cloudbianca/wien-bridge-oscillator/Simulations/temp fmin zoom.jpg

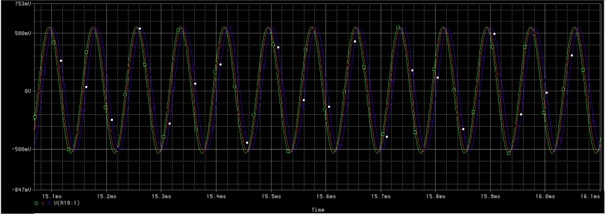
Simulations/temp fmin zoom.jpg
