cloudbianca/wien-bridge-oscillator/Simulations/temp zoom.jpg

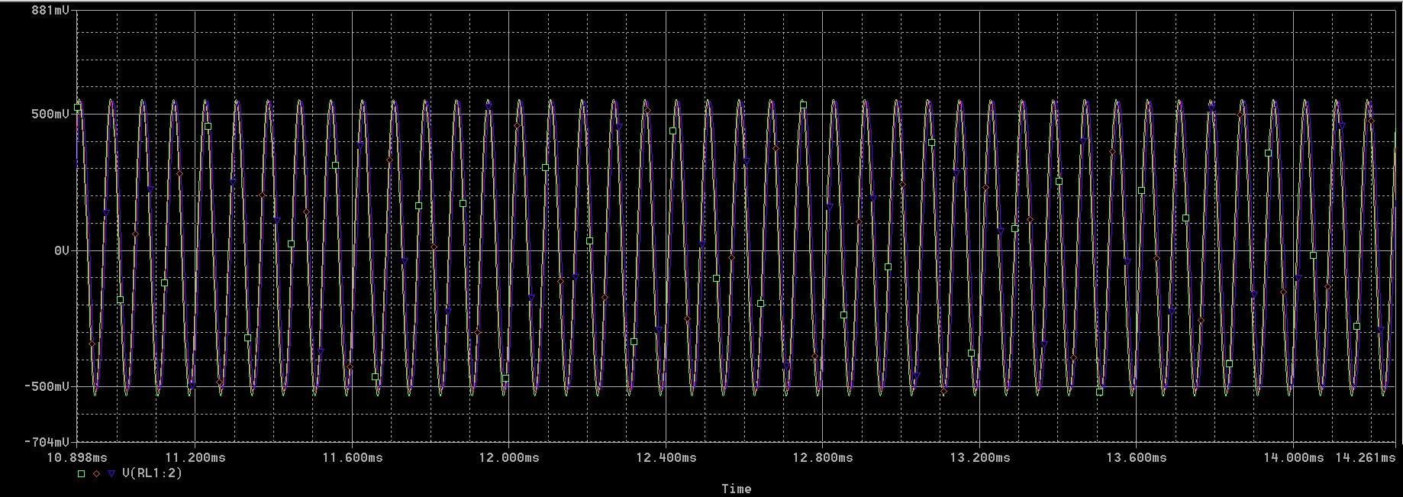
Simulations/temp zoom.jpg
