cloudbianca/wien-bridge-oscillator/Proiect docs/Documentatie part2.pdf

# UniversitateaNaționalădeÇtiință și Tehnologie Politehnica București

Facultatea de Electronică, Telecomunicații și Tehnologia Informației

# Oscilator RC cu punte Wien

## Circuiteelectronicefundamentale2

## Proiect

## Student:Rotariu Marina-Bianca

## Grupa: 433E

## Anul: 2025-2026

## Cuprins

1. Date de proiectare

N = 25

- Frecvența de oscilație reglabilă în intervalul {0.5*25 ; 3*25} [KHz] -> {12.5;75} [KHz]
- Sarcina de la ieșire 25 [KΩ];]
- Control automat al ampltudinii de oscilație realizat cu TEC-J
- Amplitudinea oscilației la ieșire 20/1.5*25 = 0.53 [V]
- Domeniul temperaturilor de funcționare: 0

0C - 70⁰C (verificabil prin testare în temperatură);
- Semnalizarea prezenței tensiunilor de alimentare cu diodă de tip LED
2. Schema bloc a circuitului

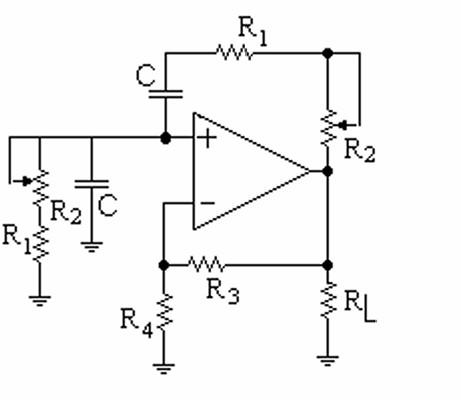
[picture p3: figure]

Putem identifica următoarele blocuri componente:

1. Amplificatorul de bază
2. Rețeaua de reacție pozitivă (rețeaua Wien) formată din R1, R2 și C
3. Rețeaua de reacție negativă formată din R3 și R4
4. Rezistența de sarcină RL

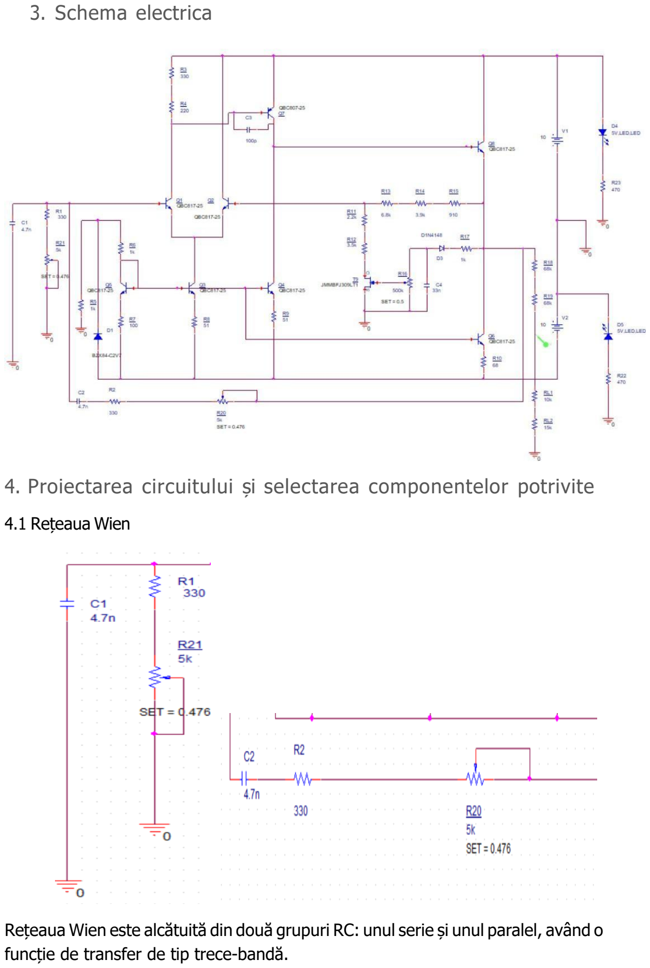
[picture p4: page 4]

3. Schema electrica
4. Proiectarea circuitului și selectarea componentelor potrivite

4.1 Rețeaua Wien

Rețeaua Wien este alcătuită din două grupuri RC: unul serie și unul paralel, având o funcție de transfer de tip trece-bandă.

Când rețeaua este atacată pe grupul serie și răspunde pe grupul paralel aceasta este cu transfer de tensiune. Când intrarea este pe grupul paralel și răspunde pe grupul serie, rețeaua este cu transfer de curent.

Este folosita datorită simplității implementării și posibilității de reglare a frecvenței de oscilație prin utilizarea unui potențiometru dublu în locul celor două rezistoare separate.

Factorul de transfer al rețelei este β =

1
, iar conform condiției de amorsare a oscilațiilor
3
Aβ = 1 => amplificarea totală a circuitului trebuie să fie egală cu 3.

Frecvența de oscilație se determină cu formula:

1
f =
2πRC

În general, în etapa de proiectare se fixează valoarea condensatoarelor, iar rezistența R se alege astfel încât să se obțină frecvența dorită.
Pentru acest scop, se utilizează un potențiometru standard de 5 kΩ, iar condensatoarele se stabilesc la C₁ = C₂ = 4.7 nF, pentru a acoperi o gamă convenabilă de reglaj a frecvenței.

Aplicând formula pentru limitele inferioară și superioară ale domeniului de frecvență

(fmin și fmax):

R =

1
2πCf

Rezultă:

- pentru fmin = 12.5 kHz, Rmax = 2700 Ω (SET = 0.476)
- pentru fmax = 75 kHz, Rmin = 450 Ω (SET = 0.024)

Datorita faptului ca nu beneficiez de o rezistenta de valoarea Rmin = 450Ω, am ales sa folosesc un rezistor de 330 Ω si sa reglez potentiometrul la valoarea de 0.024 astfel acumuland restul de 120 Ω lipsa.

4.2 Rețeaua de reacție negativă formată din R3 și R4;

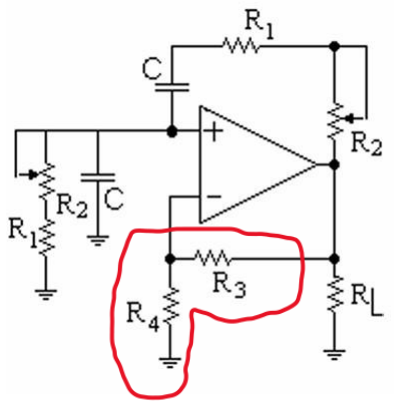
[picture p5: figure]

Bucla de reacție negativă are rolul de a stabiliza amplificarea în tensiune la o valoare constantă. Această amplificare este determinată exclusiv de valorile rezistențelor R3 si R4, conform relației:

A = 1 +

R3
R4

Pentru a îndeplini condiția lui Barkhausen, rezistența R3 trebuie să fie aproximativ de două ori mai mare decât R4, astfel încât amplificarea totală să fie cel puțin egală cu 3.

Dacă se alege R4 = 5.5 kΩ => R3trebuie să aibă o valoare teoretică de aproximativ 11.61 kΩ. În practică, această valoare se ajustează ușor peste cea teoretică pentru a garanta pornirea oscilațiilor si stabilizarea acestora.

4.3 Control automat al amplitudinii de oscilație realizat cu TEC-J

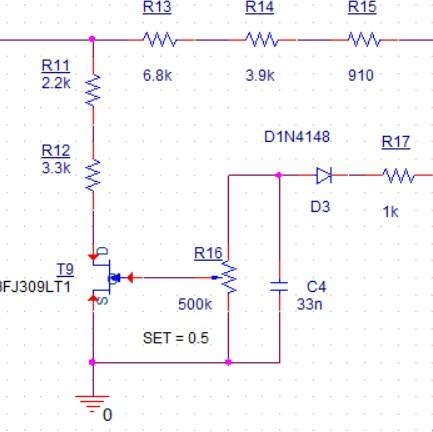
[picture p6: figure]

Detecția amplitudinii:

Dioda D3 împreună cu condensatorul C4 preiau semnalul de la ieșirea oscilatorului. Dioda realizează redresarea semnalului, iar condensatorul îl filtrează, obținându-se astfel o tensiune continuă proporțională cu amplitudinea oscilațiilor.

Controlul rezistenței:

Tensiunea continuă obținută este aplicată pe poarta tranzistorului JFET, care acționează ca o rezistență variabilă între drenă și sursă. Valoarea acestei rezistențe se modifică în funcție de tensiunea de pe poartă.

Reglarea câștigului:

Rezistența variabilă a tranzistorului JFET este inclusă în rețeaua de stabilire a câștigului amplificatorului din oscilator.

Atunci când amplitudinea oscilațiilor crește, tensiunea de control devine mai mare, determinând creșterea rezistenței. În consecință, câștigul amplificatorului scade, readucând amplitudinea la valoarea dorită.

În situația opusă, când amplitudinea scade, rezistența se diminuează, ceea ce mărește câștigul amplificatorului și restabilește amplitudinea corectă a oscilațiilor.

4.4 Amplificatorul de baza

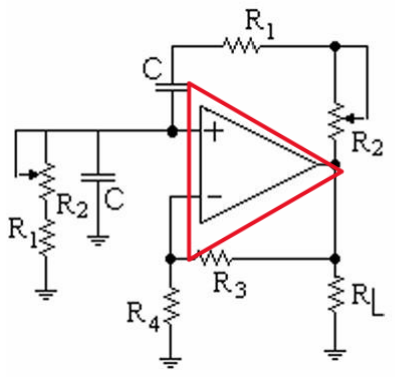
[picture p7: figure]

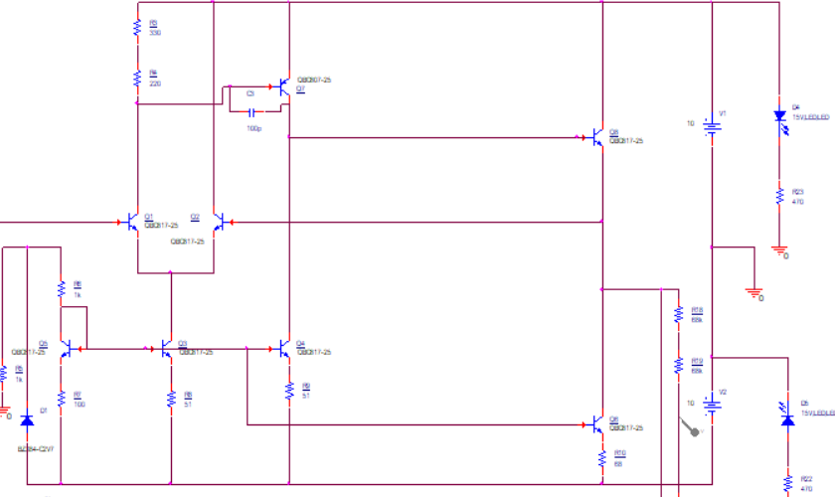
[picture p8: figure]

Acesta este un amplificator audio de putere în clasă AB, realizat într-o structură clasică pe trei etaje, optimizată pentru performanță ridicată.

1. Etajul de intrare

Tranzistoarele Q1 și Q2 alcătuiesc o pereche diferențială care primește semnalul de intrare. Împreună cu oglinda de curent formată din Q3 și Q5, acest etaj asigură un câștig inițial ridicat și o bună rejectare a zgomotului.

2. Etajul de amplificare în tensiune

Tranzistorul Q4, având ca sarcină activă pe Q7, realizează amplificarea principală în tensiune a semnalului, reprezentând secțiunea care furnizează cea mai mare parte a câștigului total.

3. Etajul de ieșire

Tranzistoarele Q7 și Q8 formează un etaj de tip „push-pull”, capabil să furnizeze curentul necesar sarcinii. Circuitul din jurul lui Q8 stabilește tensiunea de funcționare necesară celor două tranzistoare, astfel încât ele să preia semnalul în mod continuu, fără pauze între jumătățile de undă. În acest fel sunt eliminate distorsiunile de trecere prin zero caracteristice amplificatoarelor în clasă AB.

4.5 Etaje principale și funcții

Oglinda de curent și sursa de referință: Q3, Q5, D2

Dioda D2 creează tensiunea de referință necesară, iar tranzistoarele Q3 și Q5, configurate ca oglindă de curent, furnizează un curent constant care alimentează etajele sensibile. Astfel, circuitul este menținut stabil chiar dacă tensiunea de alimentare variază.

Sursă suplimentară de curent: Q4, Q6

Aceste tranzistoare extind rețeaua de alimentare cu curent constant și asigură polarizarea independentă a altor secțiuni, îmbunătățind separarea funcțională și stabilitatea ansamblului.

Etaj diferențial: Q1, Q2

Tranzistoarele Q1 și Q2 formează etajul diferențial care primește semnalul de intrare. Acesta oferă un bun raport de respingere a modului comun și stabilește baza pentru oscilații. Curentul stabil furnizat de oglinda de curent menține funcționarea corectă a etajului.

Etajul de amplificare în emitor comun: Q7

Tranzistorul Q7 amplifică semnalul provenit din etajul diferențial. Împreună cu rezistențele asociate, influențează factorul de calitate și lățimea de bandă a oscilatorului, contribuind la forma finală a semnalului generat.

Etajul de ieșire: Q8

Acest etaj asigură livrarea semnalului către sarcină, oferind curentul și tensiunea necesare pentru o ieșire stabilă și neafectată de variațiile în rețelele interne.

Rețeaua Wien: R1, R2, C1, C2, R20, R21

Rețeaua RC variabilă formată din aceste componente stabilește frecvența de oscilație. Reglajul potențiometrelor permite acoperirea intervalului 12.5–75 kHz, adaptând oscilatorul la cerințele utilizatorului.

Rețeaua de reacție negativă: R11, R12, R13, R14, R15

Aceste rezistențe fixează nivelul de feedback negativ, menținând câștigul aproape de valoarea critică necesară rețelei Wien (~2), astfel încât oscilațiile să fie susținute fără să crească sau să scadă necontrolat.

JFET-ul T9, dioda D3, rezistența R17 și condensatorul C4

- JFET-ul T9 acționează ca o rezistență variabilă în bucla de reacție, controlând automat câștigul.
- D3 redresează semnalul, permițând doar componenta pozitivă să încarce C4.

- C4 stochează tensiunea de vârf, creând o componentă DC lent variabilă, care reglează poarta JFET-ului.
- R17 limitează curentul și stabilește viteza de încărcare/descărcare a lui C4, reglând pragul la care amplitudinea este redusă.

Când amplitudinea crește, tensiunea rectificată devine mai mare → poarta JFET este polarizată invers → rezistența JFET crește → câștigul scade.
Când amplitudinea scade, procesul se inversează, păstrând semnalul stabil și nedistorsionat.

Capacitatea Miller: C3

Condensatorul C3 introduce feedback capacitiv, reducând banda de frecvențe și eliminând oscilațiile parazite. Ajută astfel la obținerea unei oscilații curate în intervalul dorit de 12.5 – 75 kHz.

5. Calculul analitic al circuitului

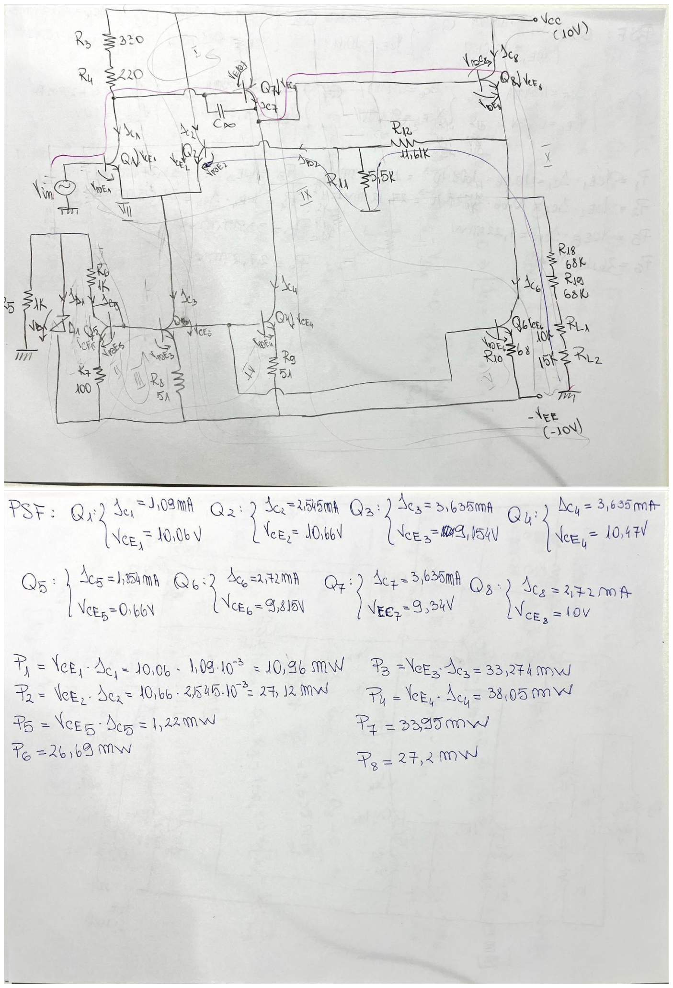
[picture p9: page 11]
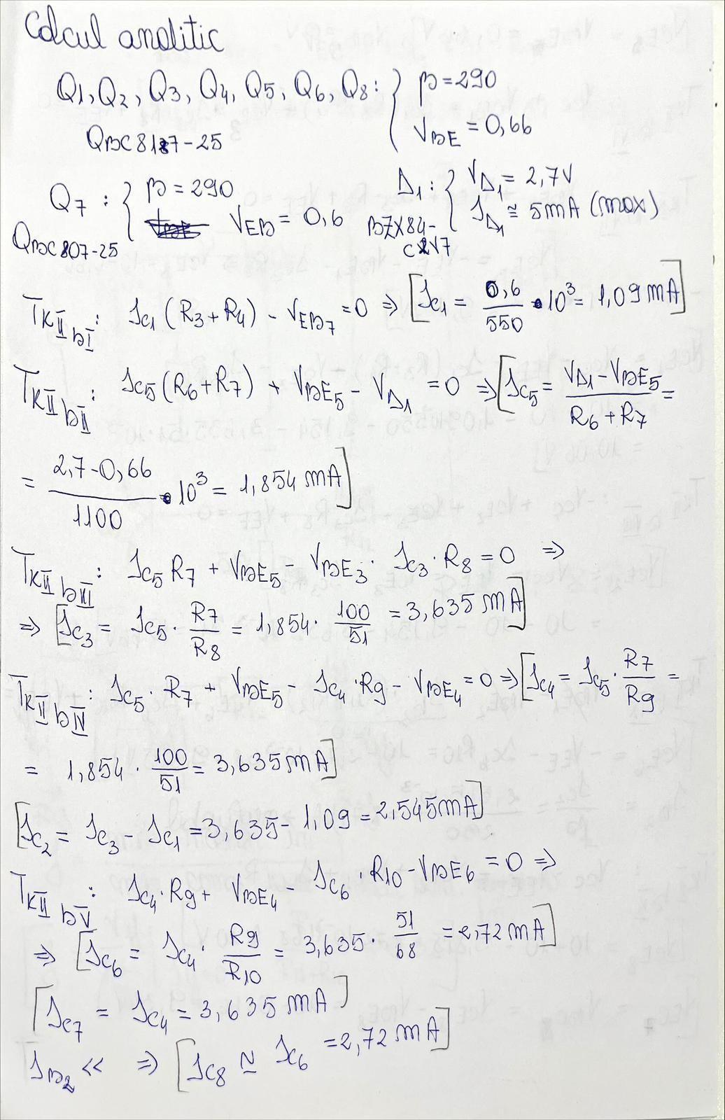
[picture p10: page 12]
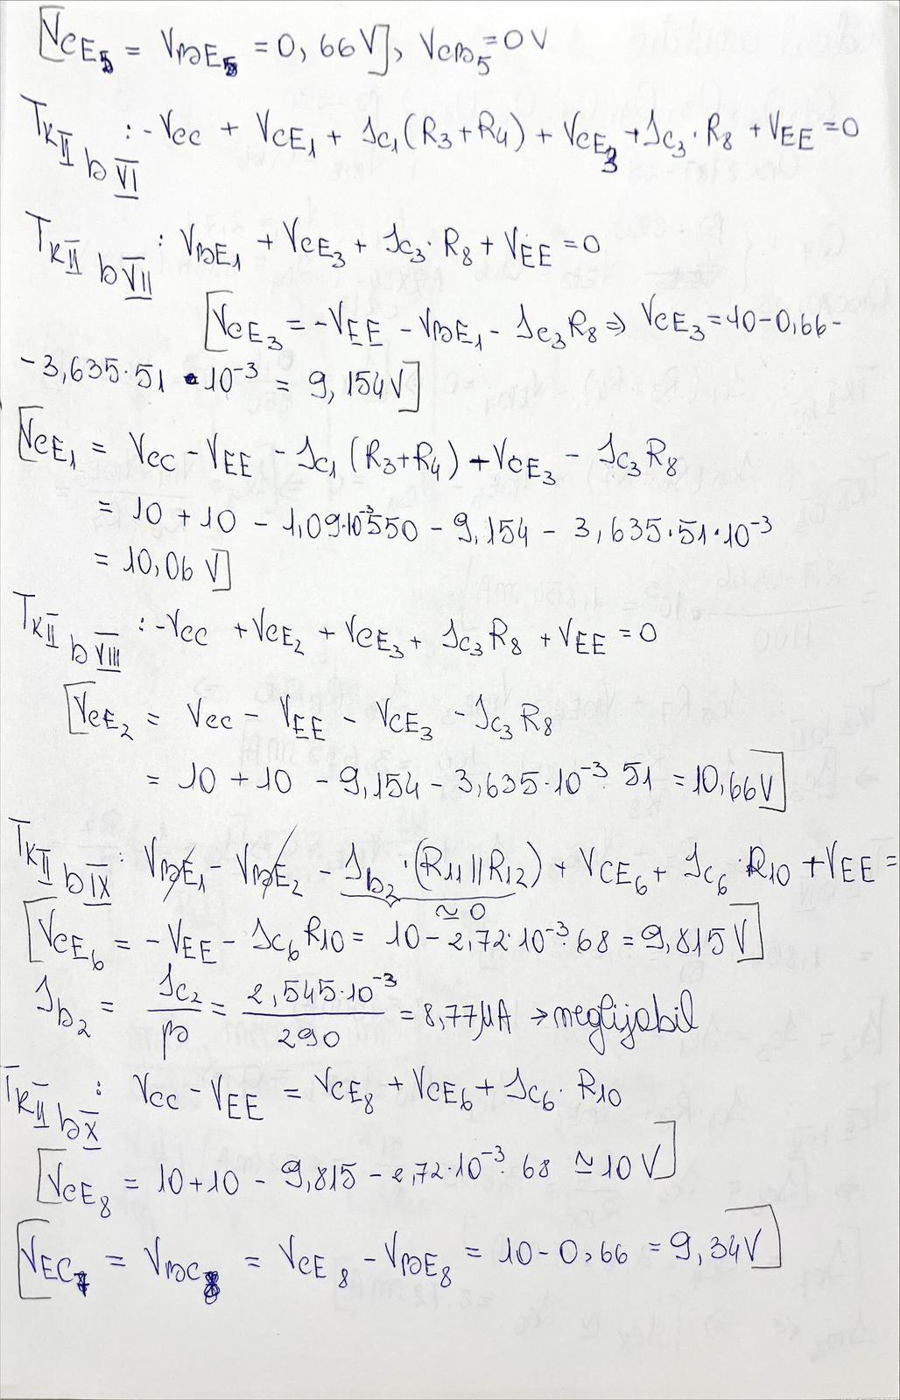
[picture p11: page 13]
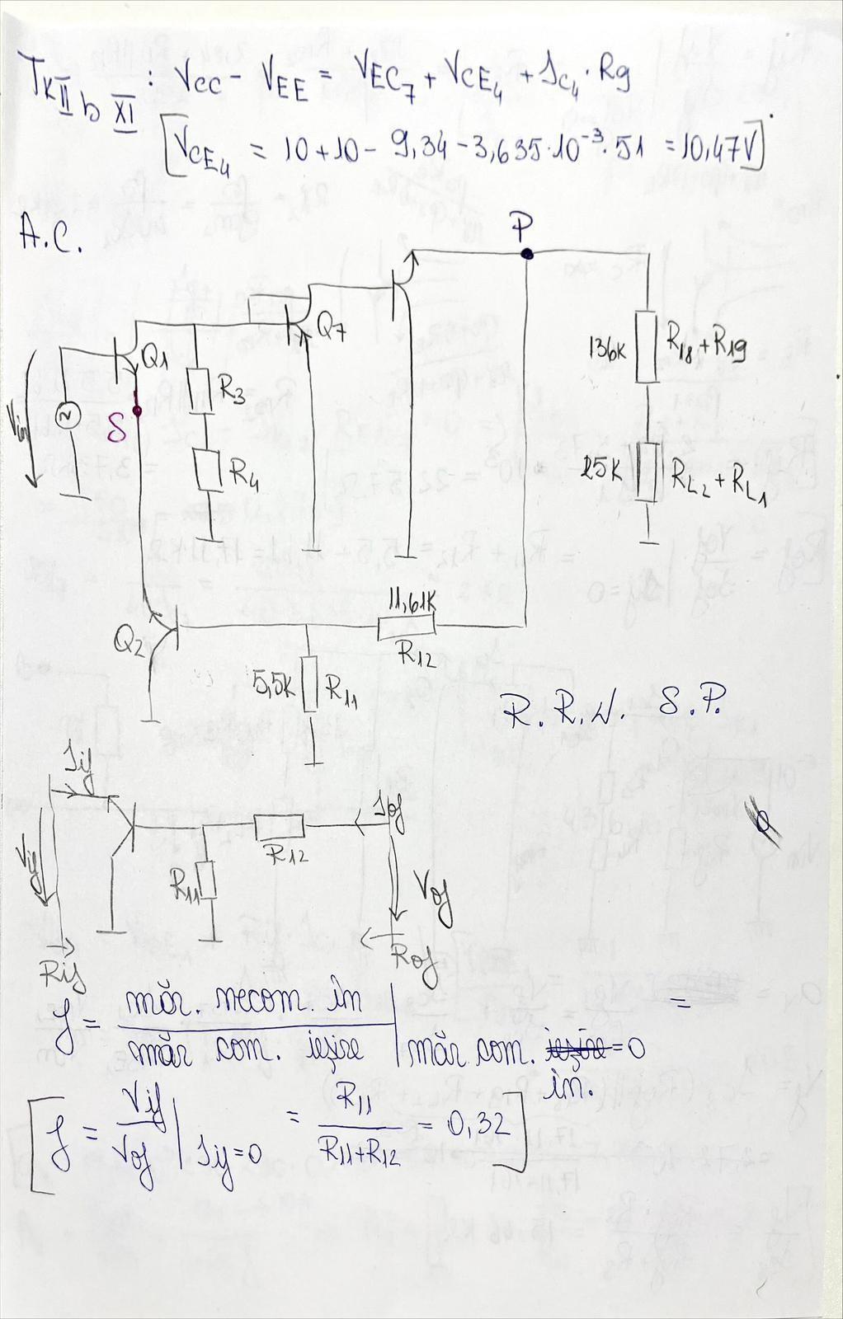
[picture p12: page 14]
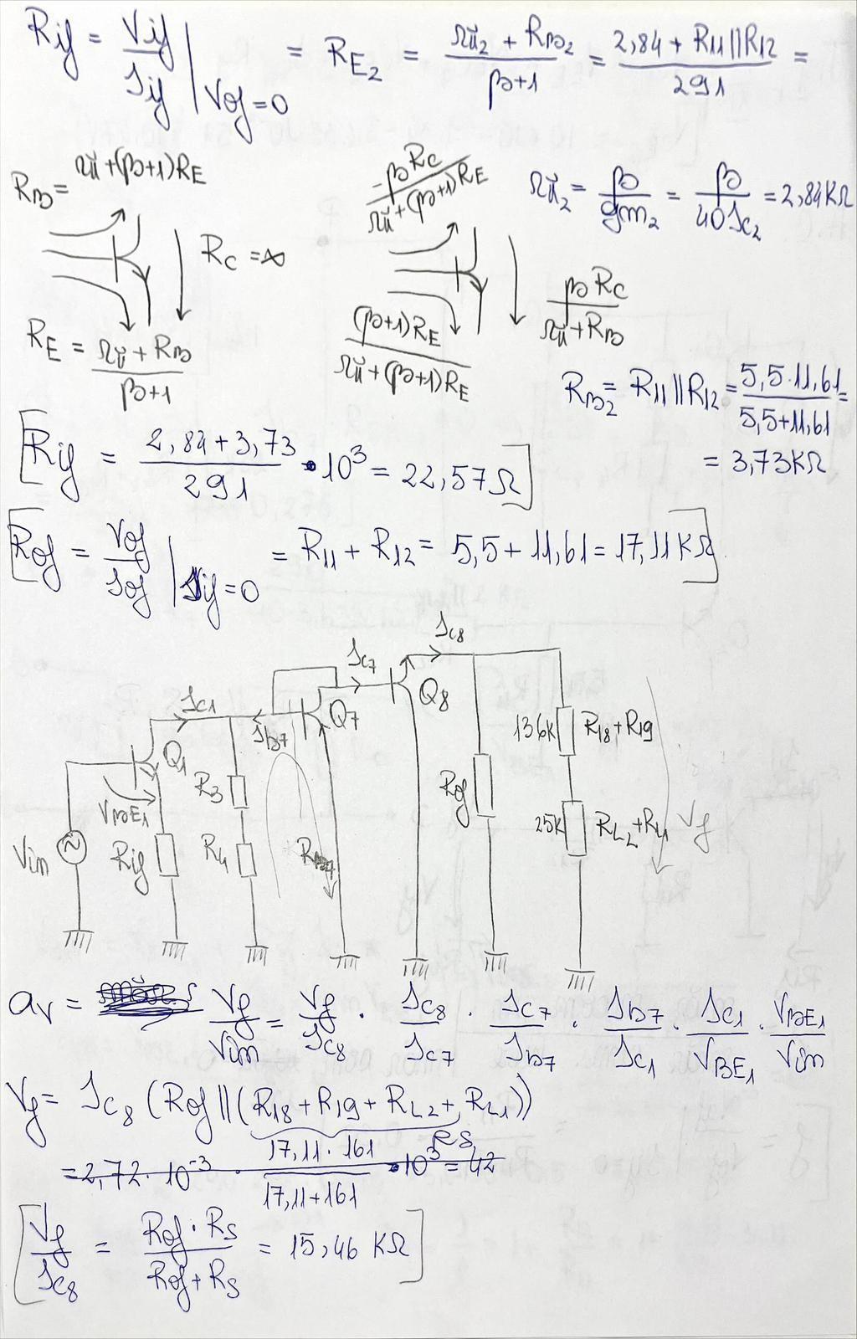
[picture p13: page 15]
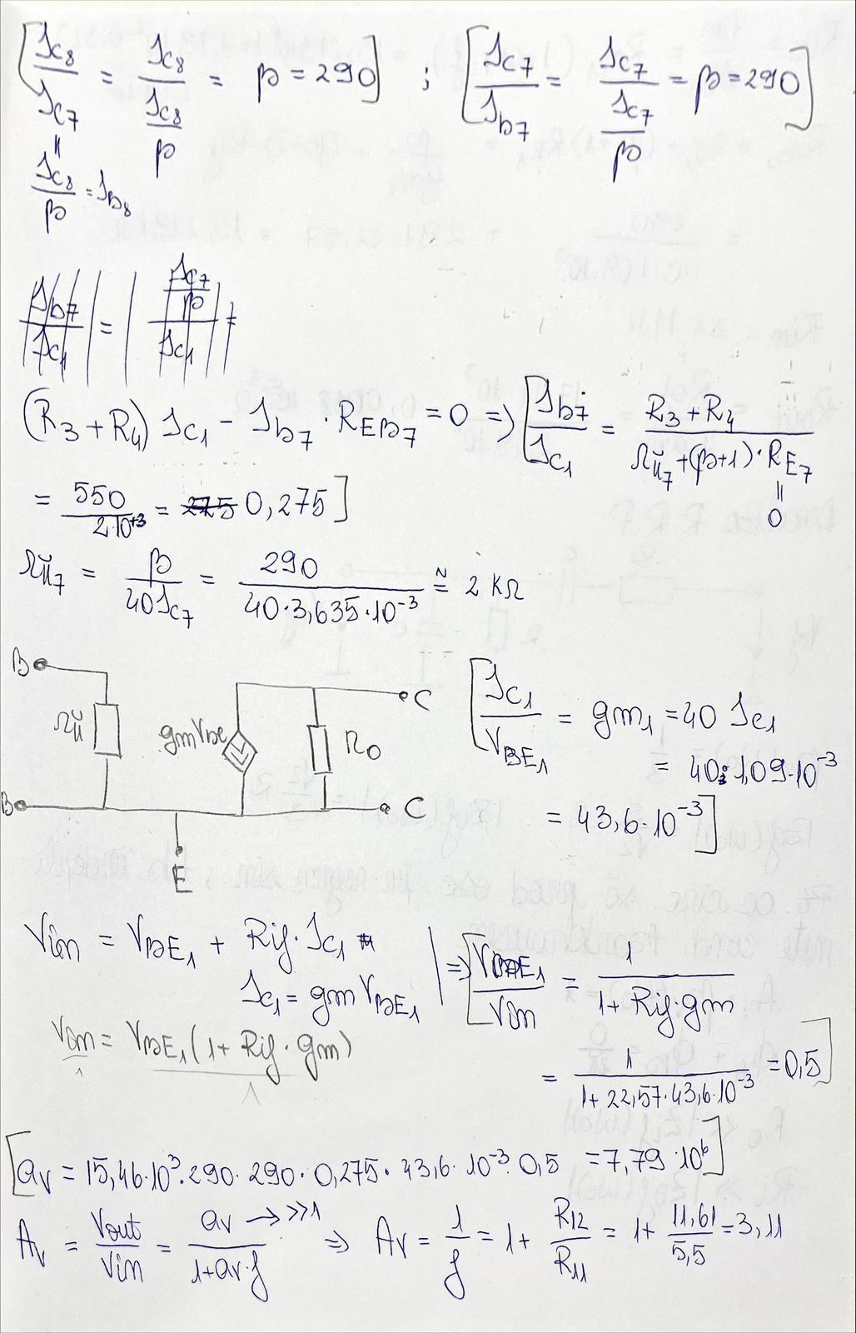
[picture p14: page 16]

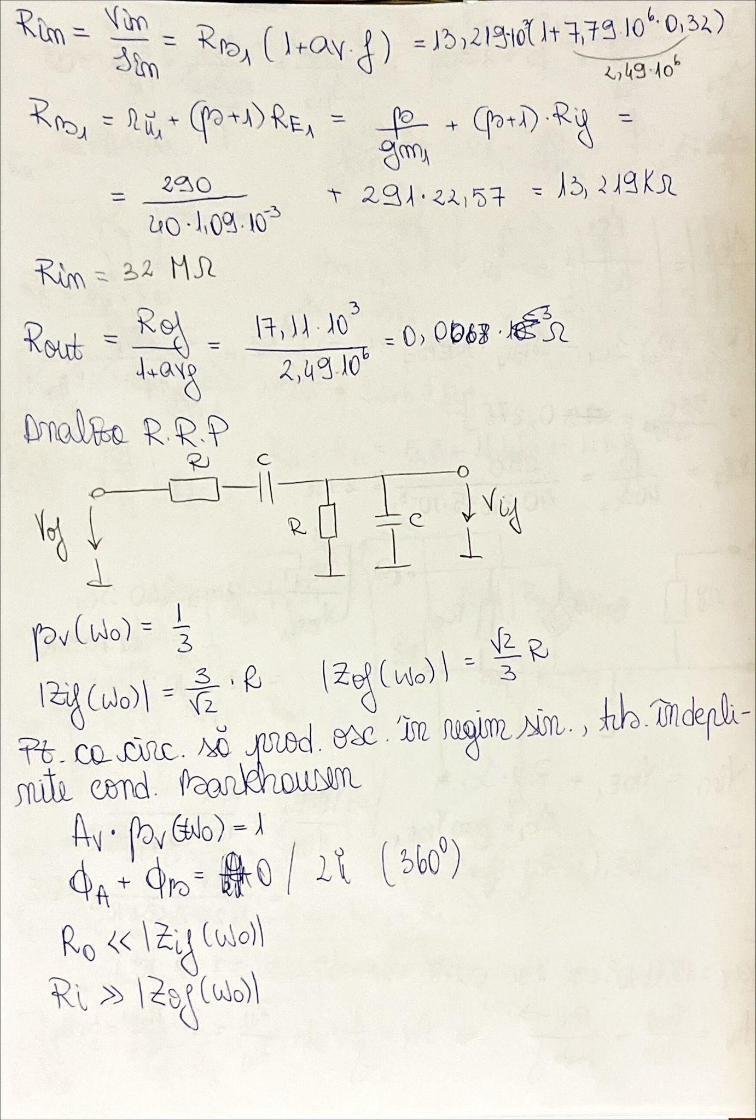
[picture p15: figure]

MENȚIUNE:
Pentru componenta D1 (BZX84-C2V7), simbolul inițial a fost asociat unui footprint de tip SOT-23.
În urma observațiilor primite la verificarea intermediară, s-a constatat necesitatea utilizării capsulei TO-
236. Am încercat sa fac asta, modificând din Orcad Capture CIS la Edit Properties, însă eram nevoită să iau proiectul de la capăt. Nu am știut prin ce altă metodă să modific doar capsula lui D1 fără să pierd toate celelalte modificări aduse celorlalte componente. Așa că am modificat pad-urile capsulei SOT23 astfel încât acestea să respecte dimensiunile și distanțele specifice ca cele ale capsulei TO236, fără să mai existe problema de dimensiune.

### 7. Layout

Layer neelectric: conturul de placă BO – Border Outline

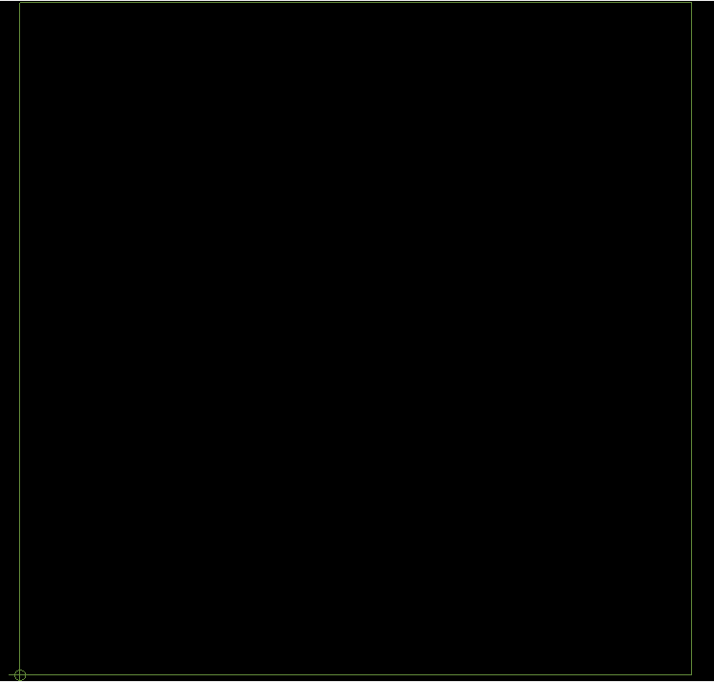
[picture p16: figure]

Layer electric BOTTOM

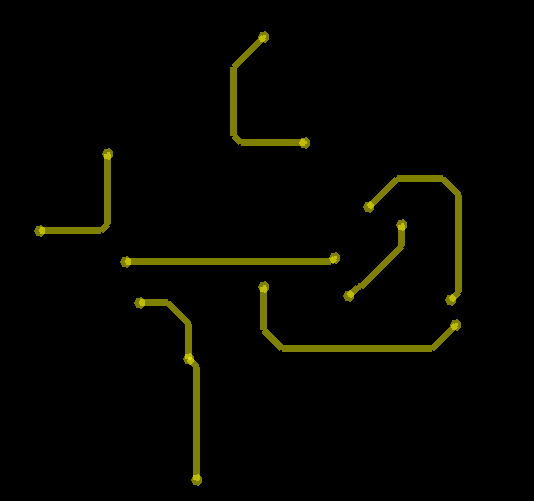
[picture p17: figure]

Layer mecanic FAB (Fabrication Drawing)

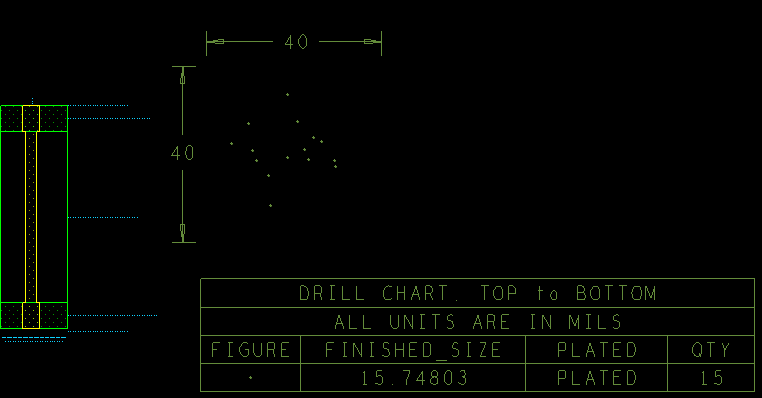
[picture p18: figure]

Layer neelectric: - masca de protecţie Bottom: SMBOT (Solder Mask Bottom);

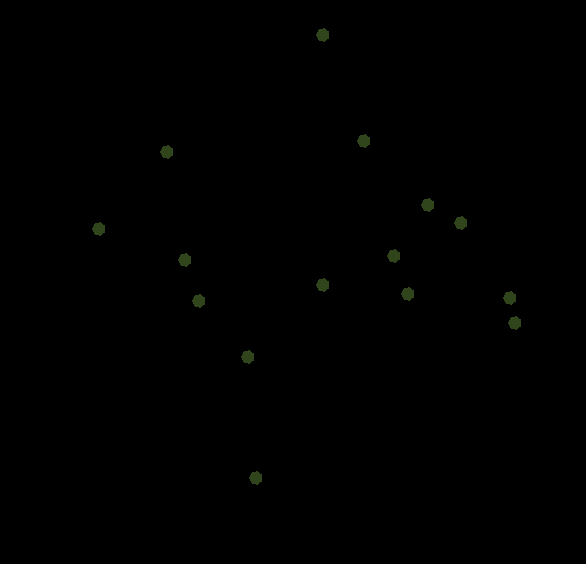
[picture p19: figure]

Layer neelectric: - masca de protecţie Top: SMTOP (Solder Mask Top);

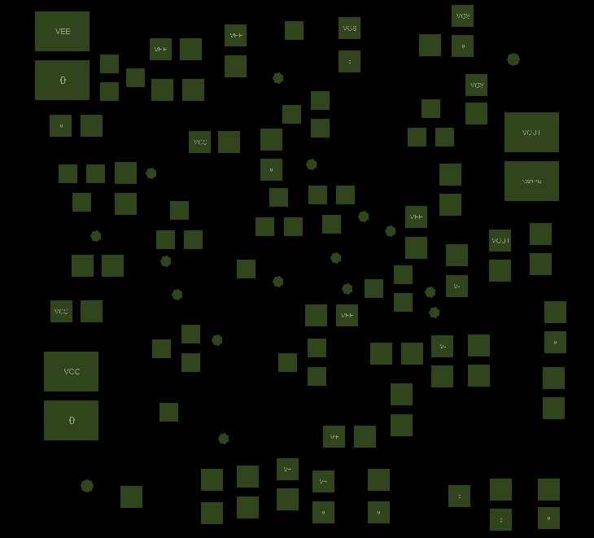
[picture p20: figure]

Layer neelectric: masca de lipire Top: SPTOP (Solder Paste/Paste Mask Top)

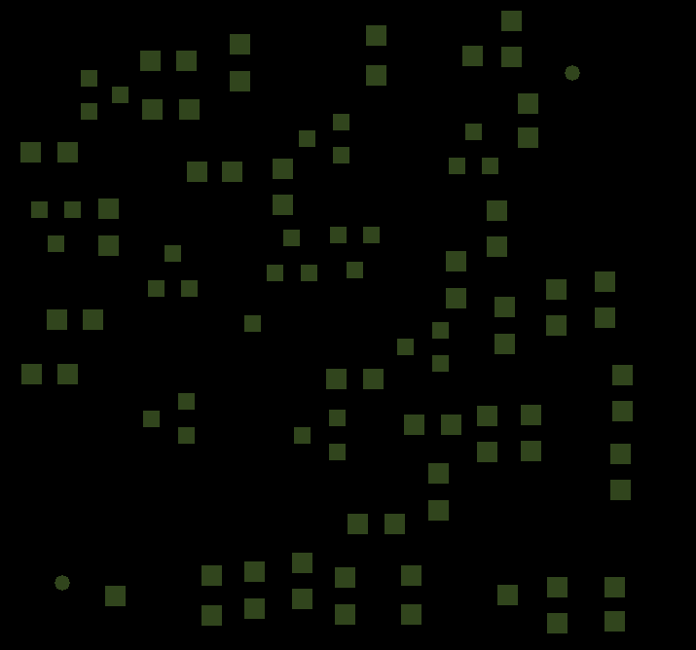
[picture p21: figure]

Layer neelectric: masca de inscripţionare Top: SSTOP (Silk Screen Top);

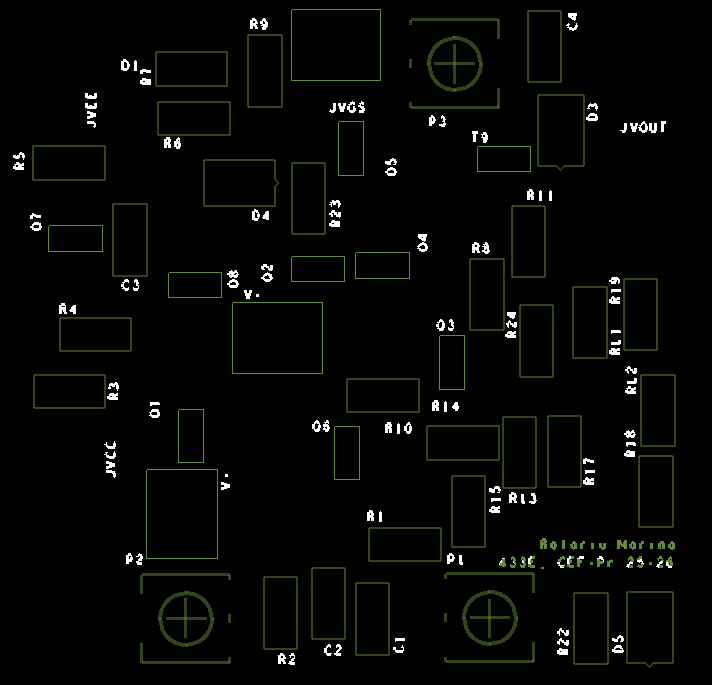
[picture p22: figure]

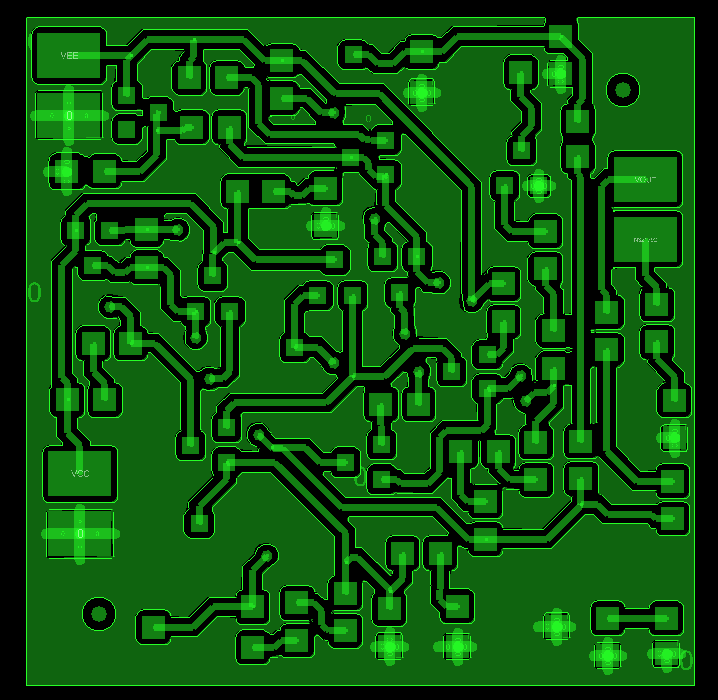
[picture p23: figure]

Layer electric: TOP
