cloudbianca/wien-bridge-oscillator/Layout/layout.jpg

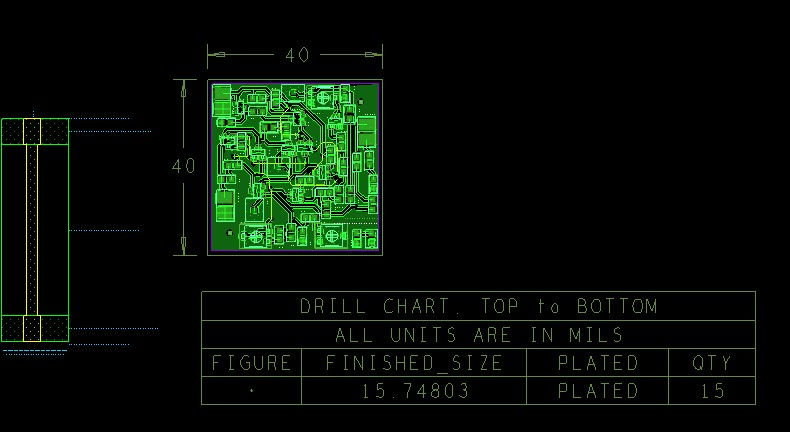
Layout/layout.jpg
