cloudbianca/wien-bridge-oscillator/Schematic.jpg

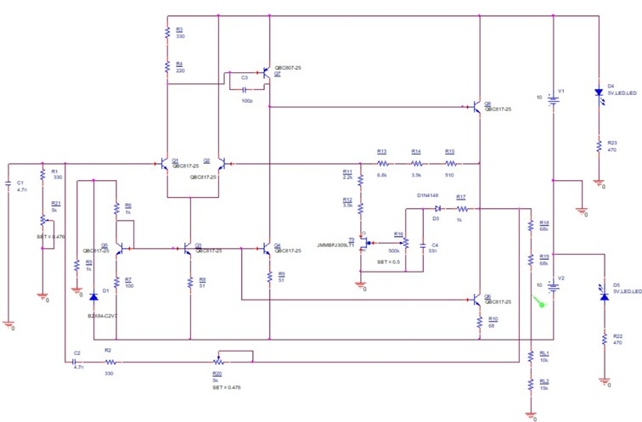
Schematic.jpg
