cloudbianca/wien-bridge-oscillator/Simulations/Amplitud V0=0.525V.jpg

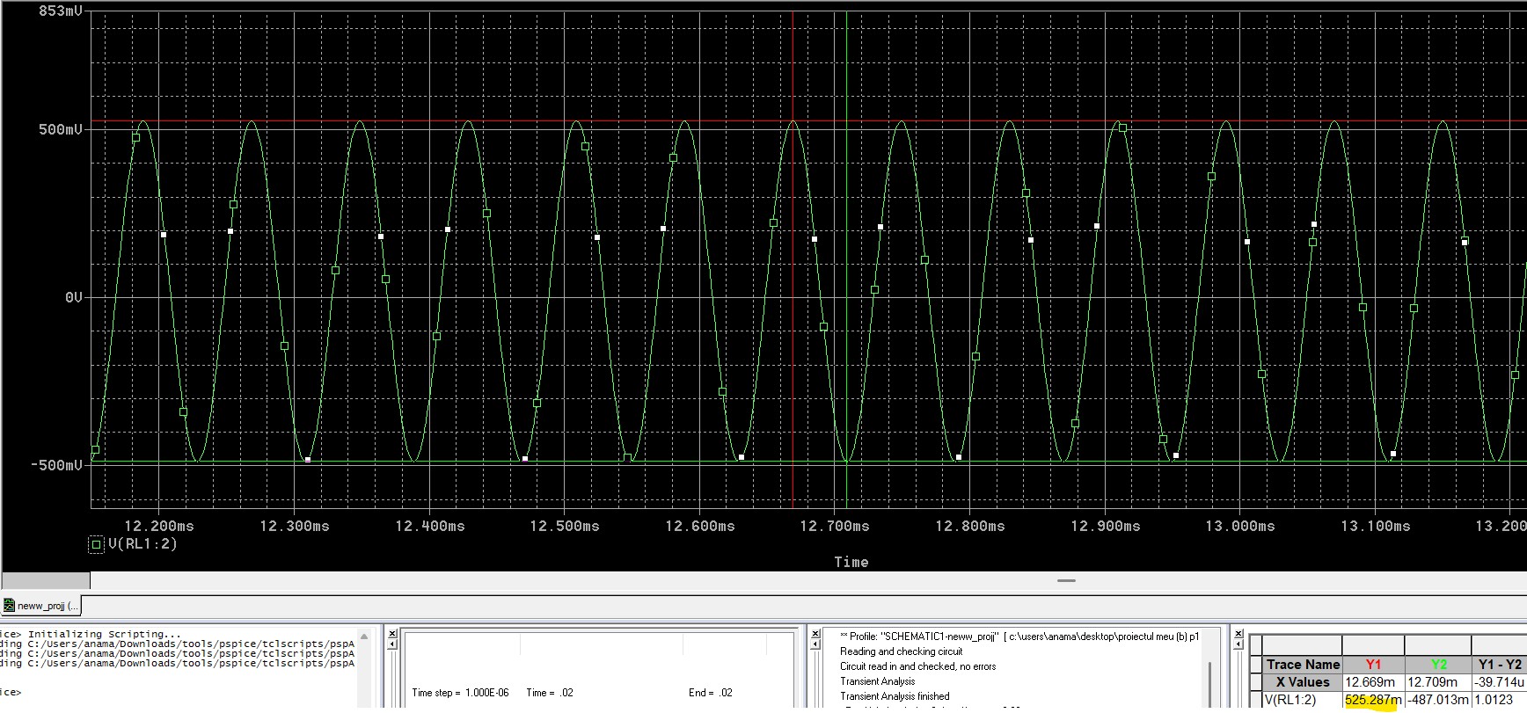
Simulations/Amplitud V0=0.525V.jpg
