cloudbianca/wien-bridge-oscillator/Simulations/carac de transfer.jpg

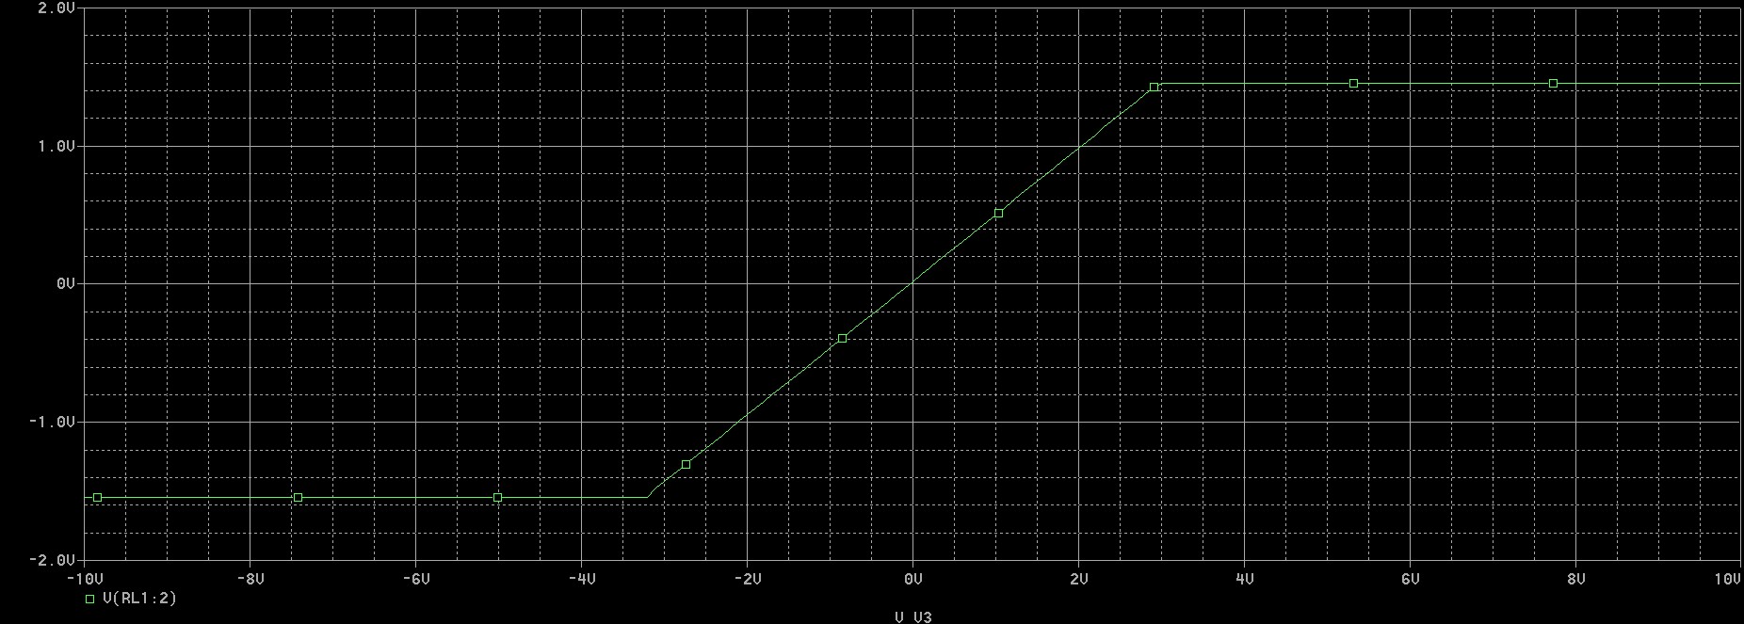
Simulations/carac de transfer.jpg
