cloudbianca/wien-bridge-oscillator/Simulations/diagrama bode.jpg

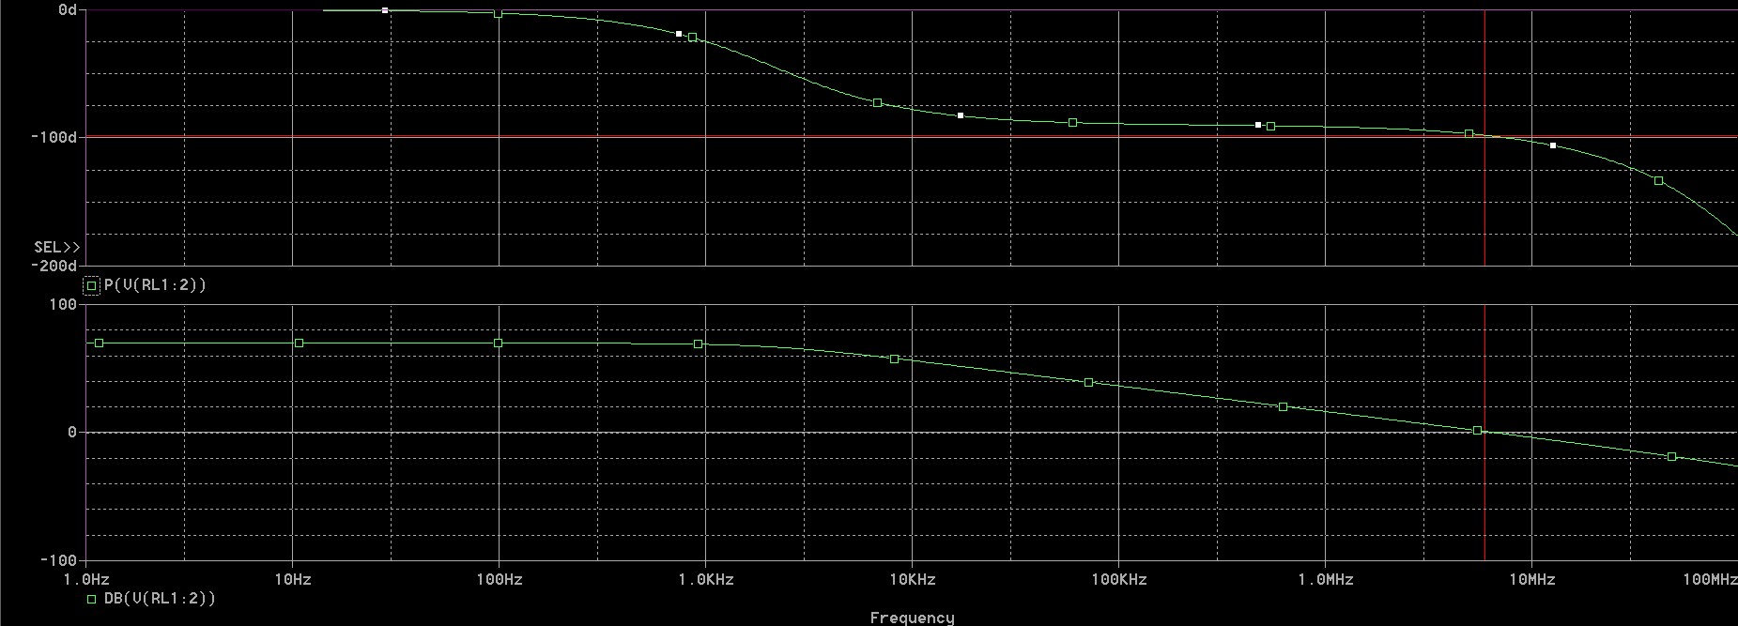
Simulations/diagrama bode.jpg
