cloudbianca/wien-bridge-oscillator/Simulations/Fmax=74,6kHz.jpg

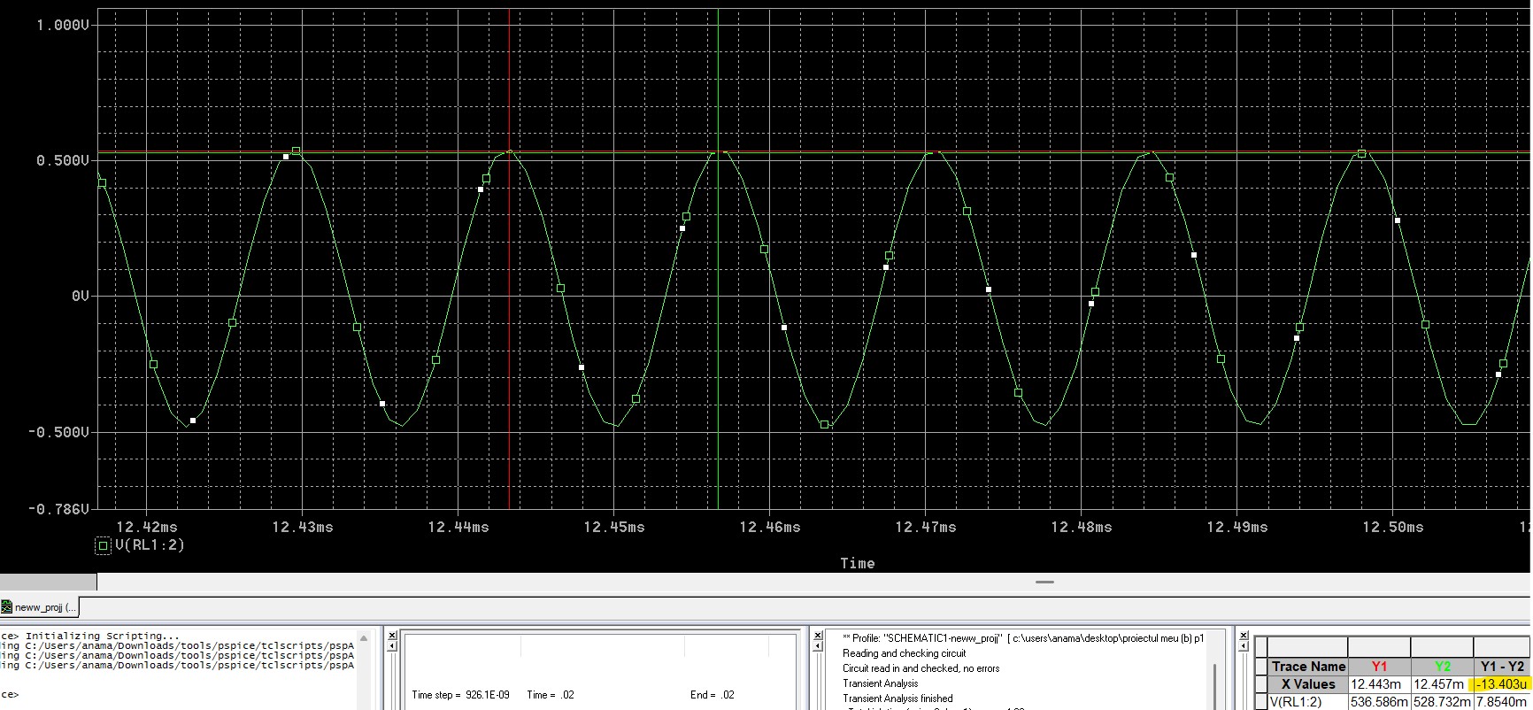
Simulations/Fmax=74,6kHz.jpg
