cloudbianca/wien-bridge-oscillator/Simulations/Fmin=12,5kHz.jpg

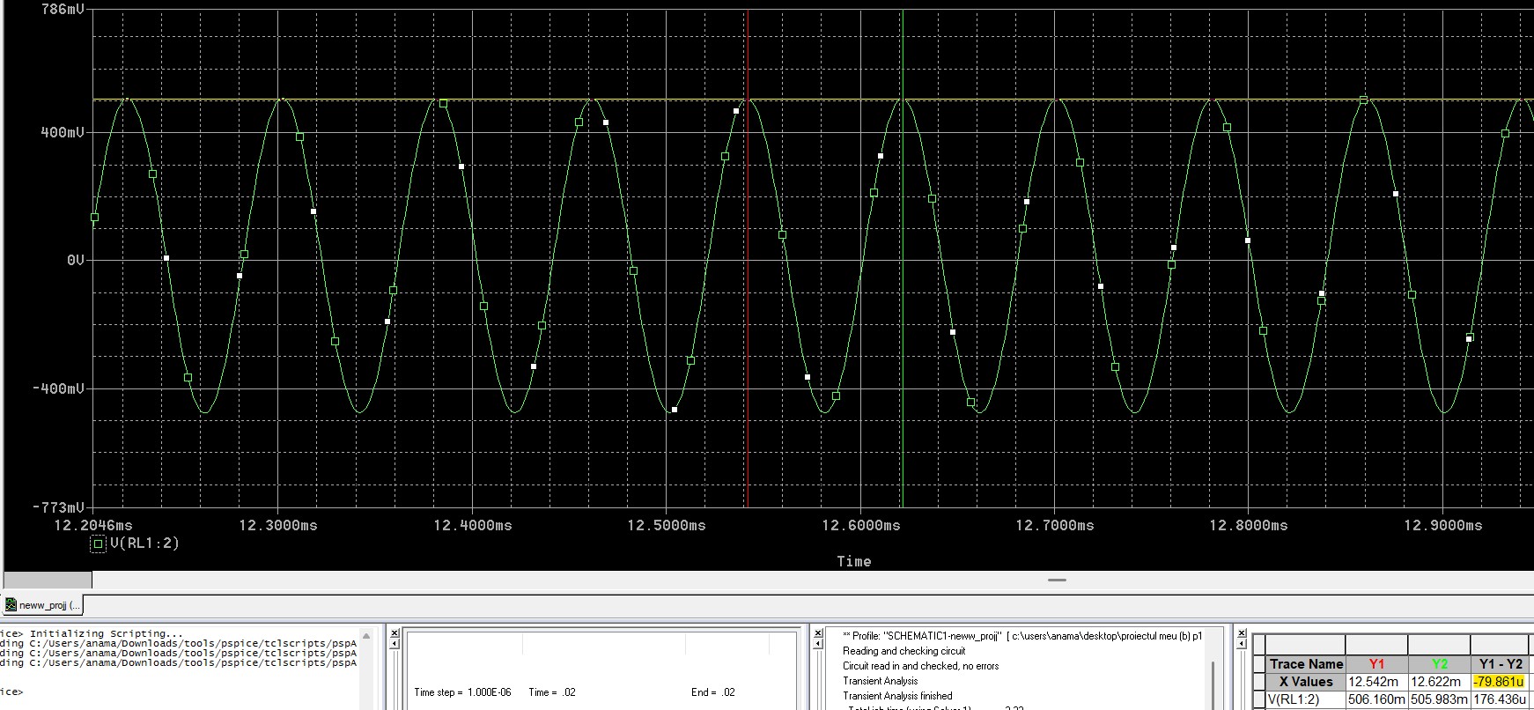
Simulations/Fmin=12,5kHz.jpg
