cloudbianca/wien-bridge-oscillator/Simulations/psf curent.jpg

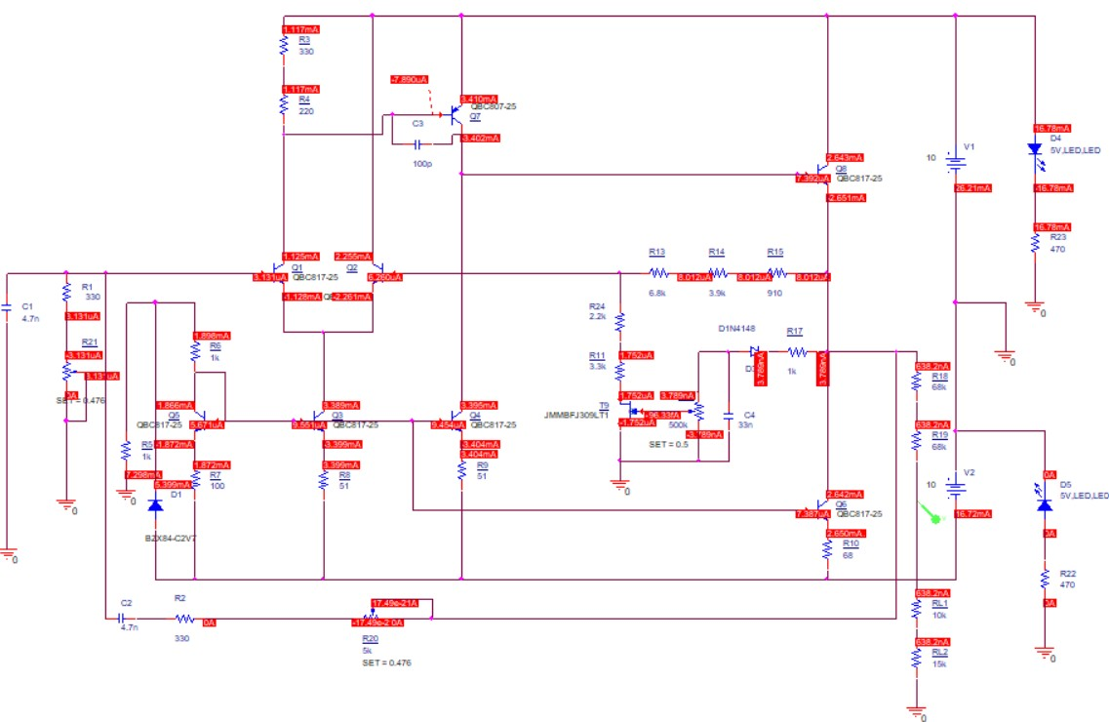
Simulations/psf curent.jpg
