cloudbianca/wien-bridge-oscillator/Simulations/psf putere.jpg

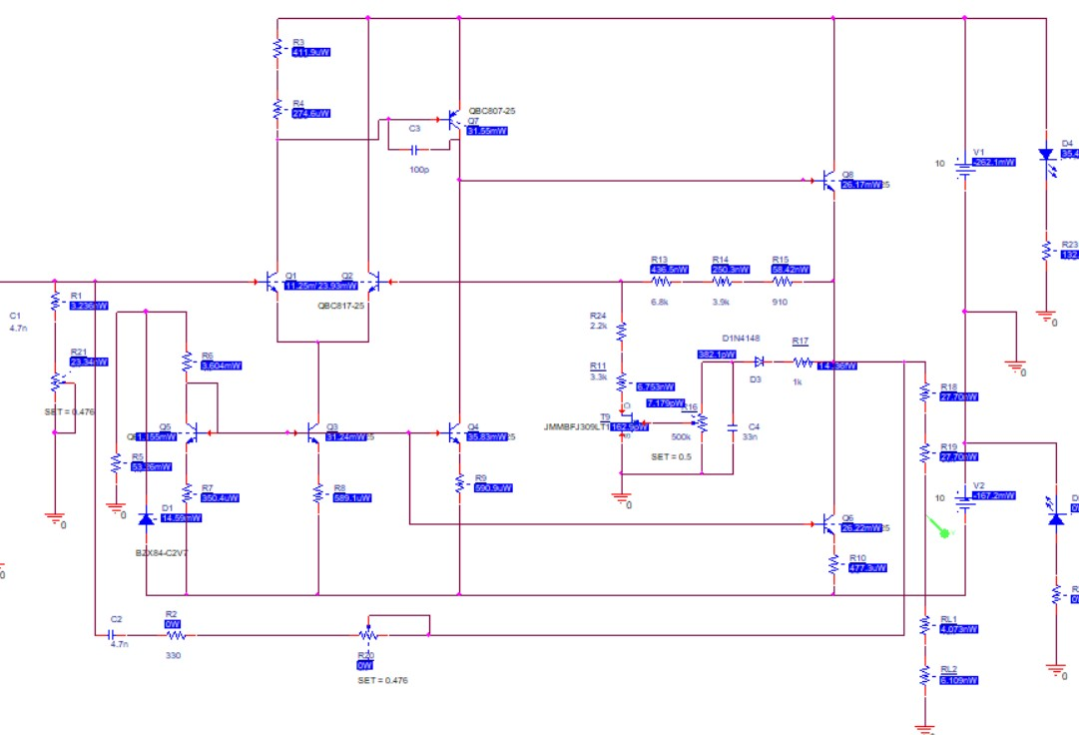
Simulations/psf putere.jpg
