cloudbianca/wien-bridge-oscillator/Simulations/psf tensiune.jpg

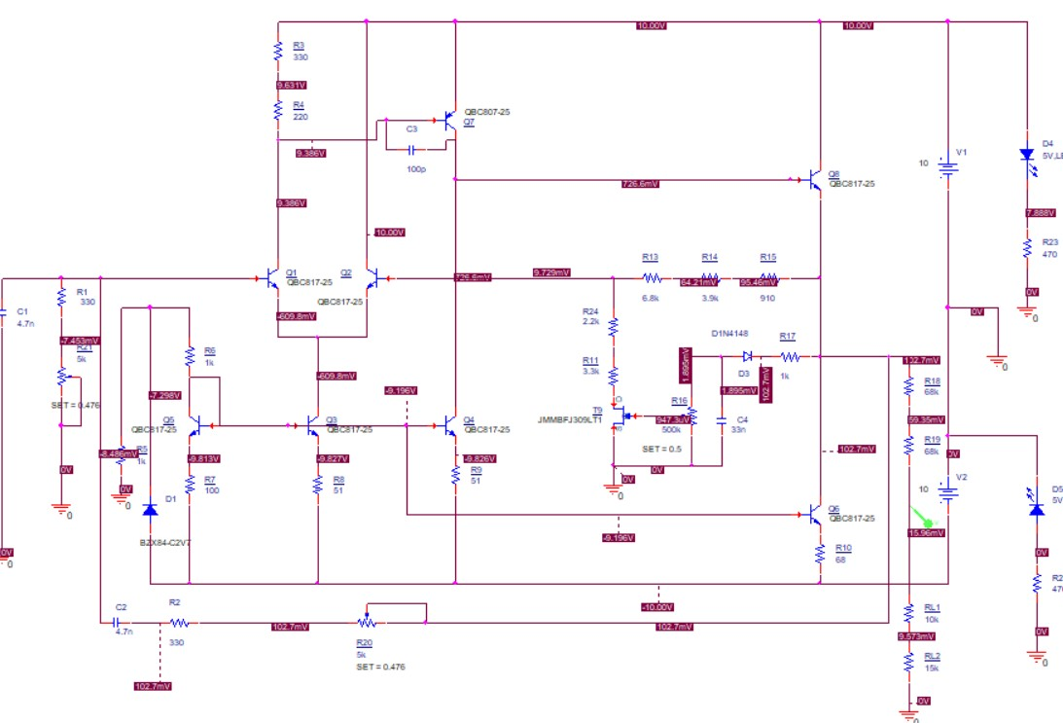
Simulations/psf tensiune.jpg
