cloudbianca/wien-bridge-oscillator/Simulations/temp fmin.jpg

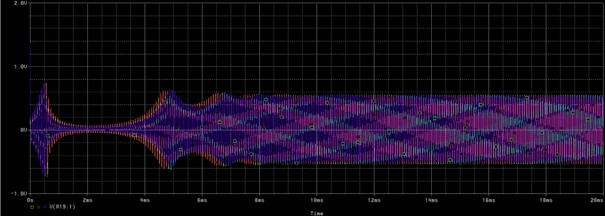
Simulations/temp fmin.jpg
