cloudbianca/wien-bridge-oscillator/Simulations/temp.jpg

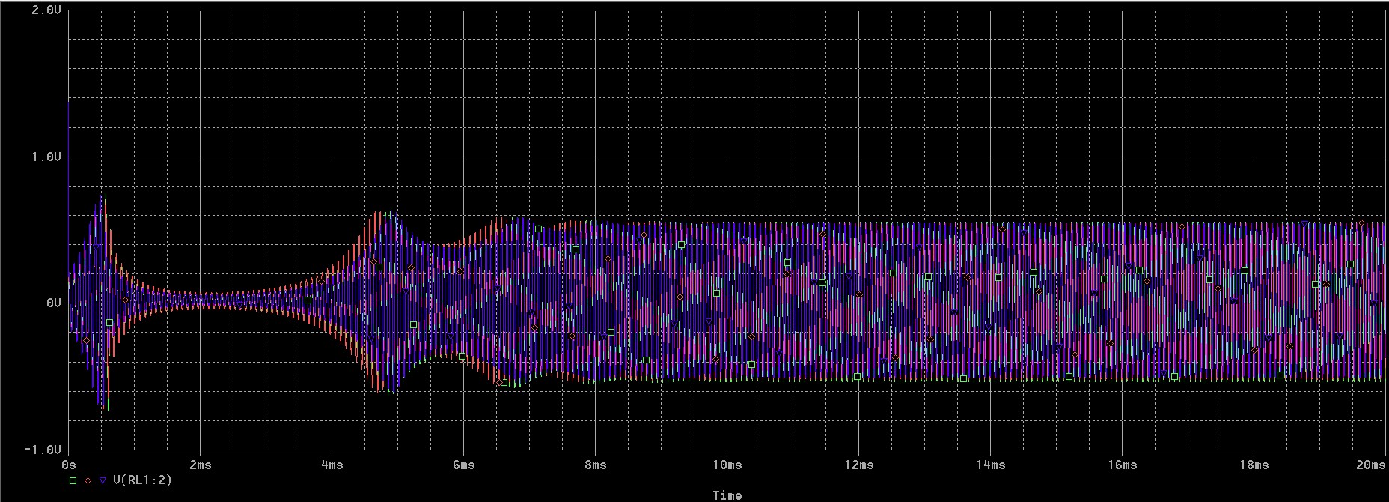
Simulations/temp.jpg
