cloudbianca/wien-bridge-oscillator/(list of files, drawings)

Other design files:
NEWW_PROJJ.DSN
neww_projj.opj
